JH-2108/RP2040-devboard/BOM.csv

Item | Qty | Supplier | Cost/item | Total Cost | link
Raspberry Pi RP2040CT | 1 | Cytron | $1.15 | $1.15 | https://my.cytron.io/p-raspberry-pi-rp2040-mcu-ic-single-unit
Winbond W25Q128JVSIQ | 1 | LCSC | $2.52 | $2.52 | https://www.lcsc.com/product-detail/C113767.html
12 MHz SMD crystal, 3225 4-pin | 5 | LCSC | $0.10 | $0.50 | https://www.lcsc.com/product-detail/C518158.html
USB Type-C 16-pin receptacle | 1 | Shopee Malaysia | $0.65 | $0.65 | https://shopee.com.my/Type-C-3.1-Patch-Socket-6P-16P-24P-Countersunk-Board-1.6-0.8mm-USB-Female-Socket-Data-Interface-i.513412485.42610897264
3.3 V LDO regulator | 1 | Shopee Malaysia | $0.46 | $0.46 | https://shopee.com.my/AMS1117-Voltage-Regulator-IC-SOT-223-1.2V-1.5V-1.8V-2.5V-3.3V-5V-i.1412281456.49416215365
10 µF ceramic capacitor | 1 | Shopee Malaysia | $0.60 | $0.60 | https://shopee.com.my/100PCS-0603-SMD-Chip-Multilayer-Ceramic-Capacitor-330PF-22uF-1nF-10nF-15nF-100nF-0.1uF-1uF-2.2uF-4.7uF-10uF-i.1135937572.21395687476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
100 nF ceramic capacitor | 10 | Shopee Malaysia | $0.12 | $1.20 | https://shopee.com.my/0402-0603-0805-1206-100nF-820nF-SMD-Chip-Capacitor-i.1467039591.41834021222
5.1 kΩ resistor | 1 | Shopee Malaysia | $1.24 | $1.24 | https://shopee.com.my/SMD-0402-0603-0805-1206-RESISTOR-1K-9.1K-Ohm-i.1467039591.50009312017
1 kΩ resistor | 1 | Shopee Malaysia | $1.24 | $1.24 | https://shopee.com.my/SMD-0402-0603-0805-1206-RESISTOR-1K-9.1K-Ohm-i.1467039591.50009312017
0603 LED | 1 | Shopee Malaysia | $0.88 | $0.88 | https://shopee.com.my/SMD-0402-0603-0805-1206-RESISTOR-1K-9.1K-Ohm-i.1467039591.50009312017
Tactile push button | 1 | Shopee Malaysia | $0.31 | $0.31 | https://shopee.com.my/Button-Switch-Tactile-Push-6x6x5mm-6*6*5mm-4PIN-i.482535902.11217352127
Tactile push button | 1 | Shopee Malaysia | $0.31 | $0.31 | https://shopee.com.my/Button-Switch-Tactile-Push-6x6x5mm-6*6*5mm-4PIN-i.482535902.11217352127
2.54 mm male pin headers | 1 | Shopee Malaysia | $0.30 | $0.30 | https://shopee.com.my/Male-Header-Pins-Straight-Single-Row-40-Pin-0.1-Inch-(2.54mm)-Male-Pin-Header-Connector-PCB-Board-Pin-Connect-i.161803224.7025057004
Custom PCB | 1 | JLCPCB | $5.78 | $5.78 | https://jlcpcb.com
1uF ceramic capcitor | 2 | Shopee Malaysia | $0.45 | $0.90 | https://shopee.com.my/100PCS-0603-SMD-Chip-Multilayer-Ceramic-Capacitor-330PF-22uF-1nF-10nF-15nF-100nF-0.1uF-1uF-2.2uF-4.7uF-10uF-i.1135937572.21395687476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
27Ω resistor | 1 | Shopee Malaysia | $0.93 | $0.93 | https://shopee.com.my/Resistor-SMD-0603-2ohm-20ohm-200ohm-2.2ohm-2.4ohm-24ohm-2.4Kohm-240kohm-2.7ohm-27ohm-270ohm-2.7kohm-5-30-pcs-i.90748406.16145253823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
15pF capacitors | 1 | Shopee Malaysia | $0.80 | $0.80 | https://shopee.com.my/100-Pieces-Original-0603-Patch-Ceramic-Capacitor-50V-4.7-PF-10PF-15PF-20PF-22PF-33-10-1608-i.1922281327.48669360089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
Estimated total shipping | 1 |  |  | $7.75
