JH-2108/RP2040-devboard/PCB/devboard.kicad_pcb

## KiCad design PCB/devboard.kicad_pcb (2026-10-28)

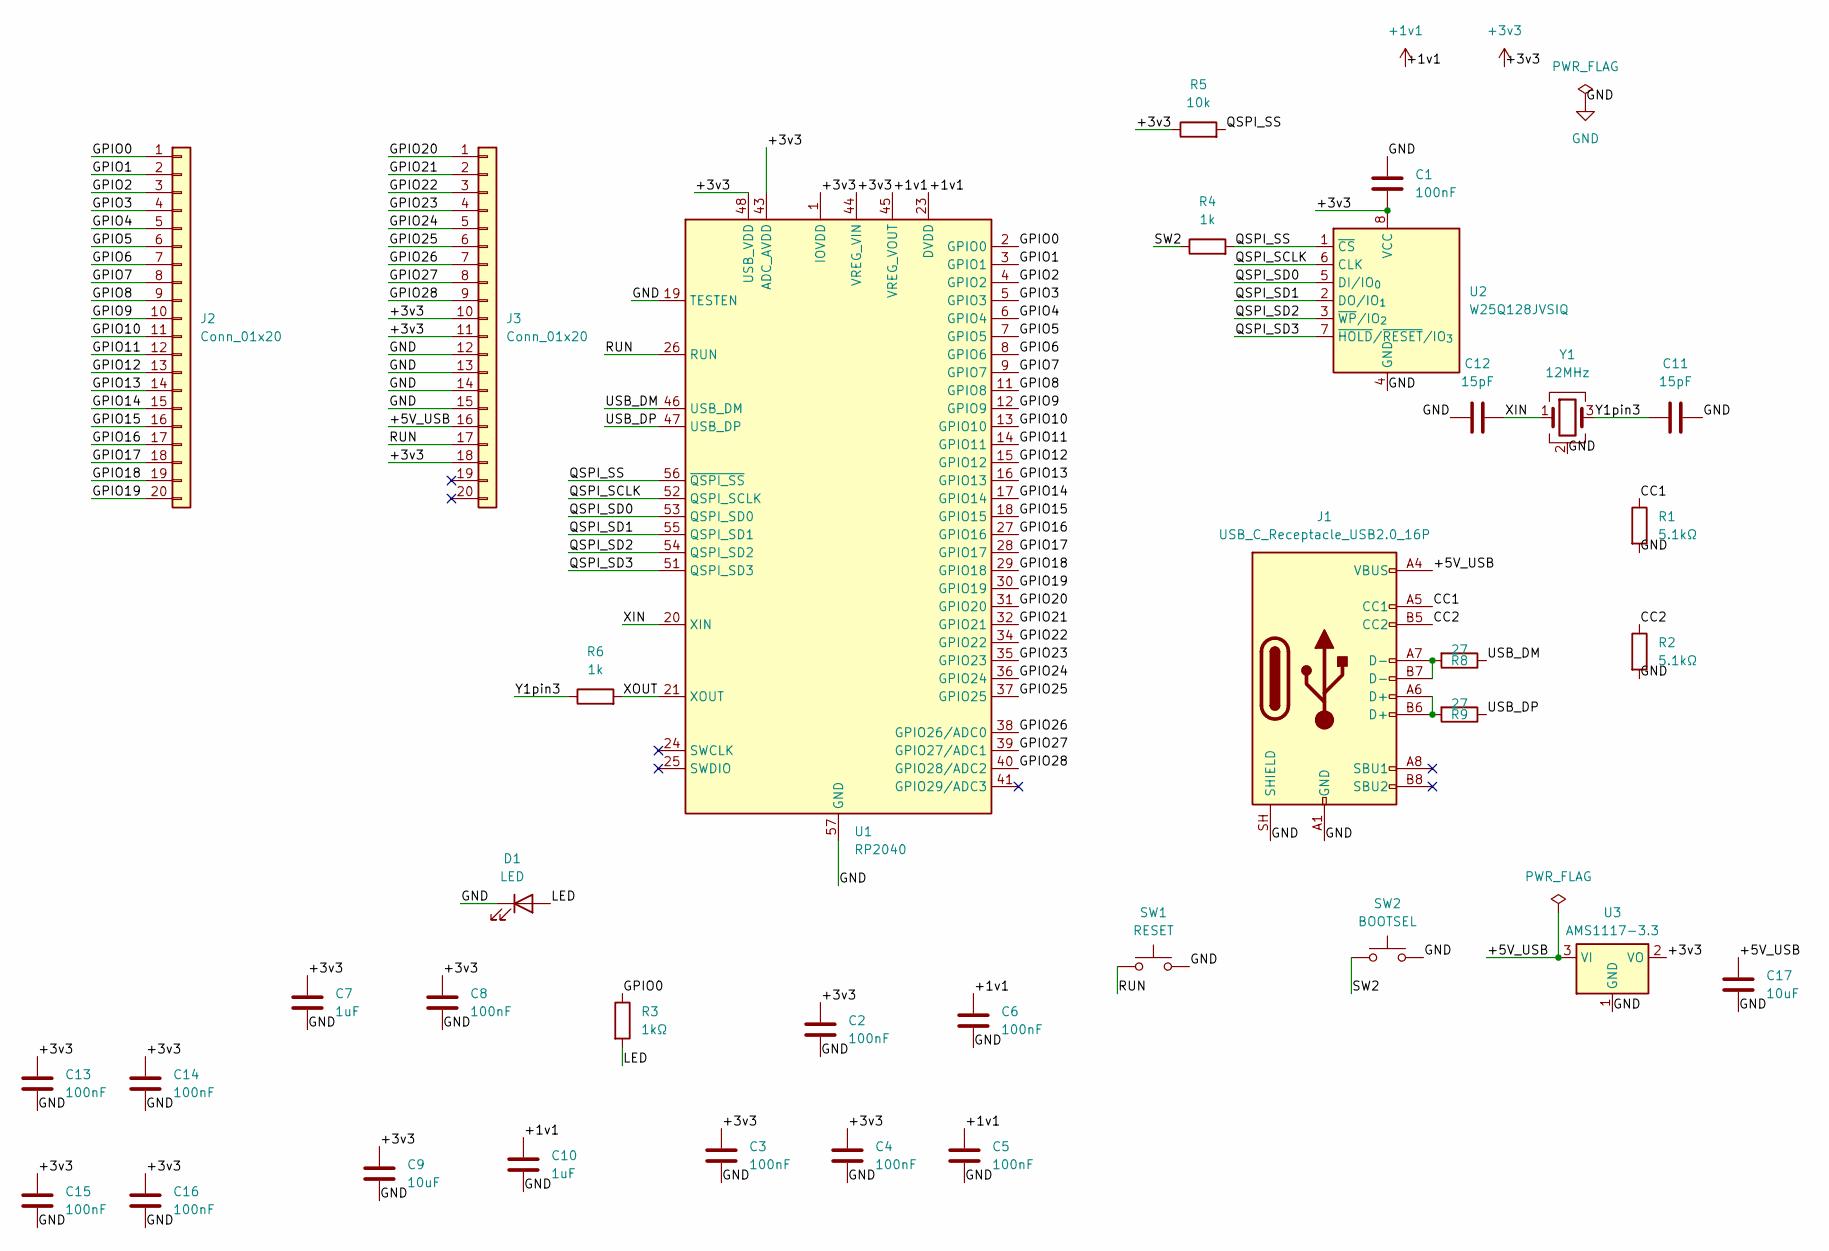
[picture p1: schematic devboard.kicad_sch]

Parts:
C1, C2, C3, C4, C5, C6, C8, C13, C14, C15, C16: 100nF; C_0603_1608Metric
C7, C10: 1uF; C_0603_1608Metric
C9, C17: 10uF; C_0603_1608Metric
C11, C12: 15pF; C_0603_1608Metric
D1: LED; LED_0603_1608Metric
J1: USB_C_Receptacle_USB2.0_16P; USB_C_Receptacle_GCT_USB4105-xx-A_16P_TopMnt_Horizontal
J2, J3: Conn_01x20; PinHeader_1x20_P2.54mm_Vertical
R1, R2: 5.1kΩ; R_0603_1608Metric
R3: 1kΩ; R_0603_1608Metric
R4, R6: 1k; R_0603_1608Metric
R5: 10k; R_0603_1608Metric
R8, R9: 27; R_0603_1608Metric
SW1: RESET; SW_Push_1P1T_NO_E-Switch_TL3301NxxxxxG
SW2: BOOTSEL; SW_Push_1P1T_NO_E-Switch_TL3301NxxxxxG
U1: RP2040; QFN-56-1EP_7x7mm_P0.4mm_EP3.2x3.2mm
U2: W25Q128JVSIQ; SOIC-8_5.3x5.3mm_P1.27mm
U3: AMS1117-3.3; SOT-223-3_TabPin2
Y1: 12MHz; Crystal_SMD_3225-4Pin_3.2x2.5mm

Connections:
+1v1: C5.1, C6.1, C10.1, U1.23 (DVDD), U1.45 (VREG_VOUT), U1.50 (DVDD)
+3v3: C1.2, C2.1, C3.1, C4.1, C7.1, C8.1, C9.1, C13.1, C14.1, C15.1, C16.1, J3.10, J3.11, J3.18, R5.1, U1.1 (IOVDD), U1.10 (IOVDD), U1.22 (IOVDD), U1.33 (IOVDD), U1.42 (IOVDD), U1.43 (ADC_AVDD), U1.44 (VREG_VIN), U1.48 (USB_VDD), U1.49 (IOVDD), U2.8 (VCC), U3.2 (VO)
/+5V_USB: C17.1, J1.A4 (VBUS), J1.A9 (VBUS), J1.B4 (VBUS), J1.B9 (VBUS), J3.16, U3.3 (VI)
/CC1: J1.A5 (CC1), R1.1
/CC2: J1.B5 (CC2), R2.1
/GPIO0: J2.1, R3.1, U1.2 (GPIO0)
/GPIO1: J2.2, U1.3 (GPIO1)
/GPIO2: J2.3, U1.4 (GPIO2)
/GPIO3: J2.4, U1.5 (GPIO3)
/GPIO4: J2.5, U1.6 (GPIO4)
/GPIO5: J2.6, U1.7 (GPIO5)
/GPIO6: J2.7, U1.8 (GPIO6)
/GPIO7: J2.8, U1.9 (GPIO7)
/GPIO8: J2.9, U1.11 (GPIO8)
/GPIO9: J2.10, U1.12 (GPIO9)
/GPIO10: J2.11, U1.13 (GPIO10)
/GPIO11: J2.12, U1.14 (GPIO11)
/GPIO12: J2.13, U1.15 (GPIO12)
/GPIO13: J2.14, U1.16 (GPIO13)
/GPIO14: J2.15, U1.17 (GPIO14)
/GPIO15: J2.16, U1.18 (GPIO15)
/GPIO16: J2.17, U1.27 (GPIO16)
/GPIO17: J2.18, U1.28 (GPIO17)
/GPIO18: J2.19, U1.29 (GPIO18)
/GPIO19: J2.20, U1.30 (GPIO19)
/GPIO20: J3.1, U1.31 (GPIO20)
/GPIO21: J3.2, U1.32 (GPIO21)
/GPIO22: J3.3, U1.34 (GPIO22)
/GPIO23: J3.4, U1.35 (GPIO23)
/GPIO24: J3.5, U1.36 (GPIO24)
/GPIO25: J3.6, U1.37 (GPIO25)
/GPIO26: J3.7, U1.38 (GPIO26/ADC0)
/GPIO27: J3.8, U1.39 (GPIO27/ADC1)
/GPIO28: J3.9, U1.40 (GPIO28/ADC2)
/LED: D1.2 (A), R3.2
/QSPI_SCLK: U1.52 (QSPI_SCLK), U2.6 (CLK)
/QSPI_SD0: U1.53 (QSPI_SD0), U2.5 (DI/IO_{0})
/QSPI_SD1: U1.55 (QSPI_SD1), U2.2 (DO/IO_{1})
/QSPI_SD2: U1.54 (QSPI_SD2), U2.3 (~WP/IO_{2})
/QSPI_SD3: U1.51 (QSPI_SD3), U2.7 (~HOLD/~RESET/IO_{3})
/QSPI_SS: R4.2, R5.2, U1.56 (~QSPI_SS), U2.1 (~CS)
/RUN: J3.17, SW1.1, U1.26 (RUN)
/SW2: R4.1, SW2.1
/USB_DM: R8.1, U1.46 (USB_DM)
/USB_DP: R9.1, U1.47 (USB_DP)
/XIN: C12.2, U1.20 (XIN), Y1.1
/XOUT: R6.2, U1.21 (XOUT)
/Y1pin3: C11.1, R6.1, Y1.3
GND: C1.1, C2.2, C3.2, C4.2, C5.2, C6.2, C7.2, C8.2, C9.2, C10.2, C11.2, C12.1, C13.2, C14.2, C15.2, C16.2, C17.2, D1.1 (K), J1.A1 (GND), J1.A12 (GND), J1.B1 (GND), J1.B12 (GND), J1.SH (SHIELD), J3.12, J3.13, J3.14, J3.15, R1.2, R2.2, SW1.2, SW2.2, U1.19 (TESTEN), U1.57 (GND), U2.4 (GND), U3.1 (GND), Y1.2 (G), Y1.4 (G)
unnamed: J1.A6 (D+), J1.B6 (D+), R9.2
unnamed: J1.A7 (D-), J1.B7 (D-), R8.2

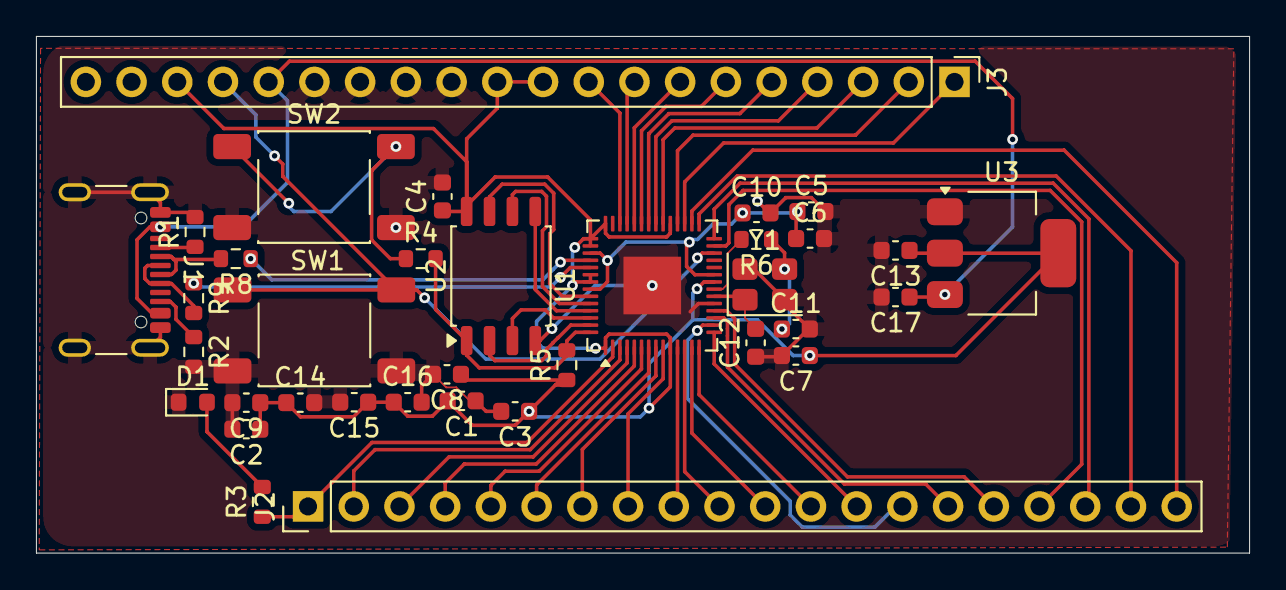
[picture p2: board devboard.kicad_pcb from above]

Board: 2 copper layers, 67.4 x 28.7 mm, 35 parts (0 on the bottom side), 51 nets.
