JH-2108/RP2040-devboard/JOURNAL.md

# Simple devboard: devlog

<!-- Generated by Half Life from project cmuvnsb3i011801o9xqn8m9wa. Edits here are overwritten on the next sync. -->
<!-- Generated: 2026-10-28T17:34:56.982Z -->

> [!NOTE]
> This devlog is mirrored from [Half Life](https://halflife.hackclub.com) ([open the project](https://halflife.hackclub.com/projects/cmuvnsb3i011801o9xqn8m9wa)). Editing it here will not change the platform's copy, and the next sync overwrites this file.

> A custom-designed, compact development board built around the Raspberry Pi RP2040 microcontroller. The board includes native USB-C connectivity, external QSPI flash, 3.3V power regulation, BOOTSEL and reset controls, status indication, and 40GPO breakout pins. It is designed as a general purpose platform for experimenting with embedded programming, sensors, displays, robotics and future hardware projects.

| Week | Tier | Hours logged | Entries |
| --- | --- | --- | --- |
| Week 1 | Tier 1 | 17.1h | 5 |

## Contents

1. [2026-10-06: **Finding an idea, learning KiCAD**](#2026-10-06-finding-an-idea-learning-kicad)
2. [2026-10-06: **PCB DESIGNING**](#2026-10-06-pcb-designing)
3. [2026-10-07: ](#2026-10-07-screenshot-2026-10-07-205429httpshalflifehackclub)
4. [2026-10-19: After completing the entire development board, there were changes regarding the sharp angles of the track connections, the crystal being too far way from the RP2040 microcontroller chip and other issu](#2026-10-19-after-completing-the-entire-development-board-the)
5. [2026-10-28: **More changes**](#2026-10-28-more-changes)

## Design

### 2026-10-06: **Finding an idea, learning KiCAD**

**2h**

**Finding an idea, learning KiCAD**

Well, I had no idea what I wanted to do when I first started, maybe a flight controller (found out it was too expensive), a macropad (was a great idea, but I've done it before and I wanna do something different), a reaction game (tried that, deleted the project because it was a bit over the budget and way to easy), and then I landed on what I have now... A DEVBOARD!!!

Besides just making my idea reel, I also fully designed the entire PCB layout and schematics in KiCAD, successfully completing the creation of the entire DevBoard, which could be manufactured right now. However, you don't know me, I like to test if it works, and during my PCB layout creation, I faced so many difficulties, like the clearance issues on a FOOTPRINT, LITERALLY DESIGNED BY KICAD... Hence, I found a way to overcome it by changing the clearance value.

In the end, it took me 2 hours to work on the PCB layout, what type of parts to use, learning how to use KiCAD, while also checking if the parts that I need for this project are all on the KiCAD symbol and footprint library. It was a ton of work, but, hey, I finally did it, I got a great difficult project idea for a cost below 30usd, a PCB design that I can really work on, which will be quite fun to do so too, and how to solder those super tiny resistors and capacitors when the parts finally arrive at my doorstep!

To summarize what I did, I basically learnt how to use KiCAD, how to solder, and sketch up some ideas, and spent some of these time filming my reel!

Anyways, enough of my yapping, here are some images of my project:





### 2026-10-06: **PCB DESIGNING**

**3.6h**

**PCB DESIGNING**

Some pictures of my PCB designing, includes the schematics, PCB, and 3d rendered version. An additional 1 hour and 30-ish minutes was used to handle certain PCB designing issues, and learning how KiCAD works! (including solving some problems that I had with KiCAD that isn't recorded in the timelapse.







[Timelapse](https://lookout.hackclub.com/api/media/49bfa0d1-a2d1-49ec-b1c6-9895ec110794/video.mp4)

[Timelapse](https://lookout.hackclub.com/api/media/312bf0b2-ec24-4d46-80e0-ec4d2dc14f10/video.mp4)

### 2026-10-07: 

**5.5h**



**PREPARING FIRMWARE ENVIRONMENT**

Well, a development board doesn't always need a firmware for it to run, since, yk, the chips provide the main codes for all the other components to run along with how you are the one coding in order to make the devboard work.

However, as for me, I decided that, yk, I have a lot of free time, and also I haven't complete my 10 hour progress for this project, hence, I decided, why not I code the firmware to test the board first, then later on, when it is time to test the board, I'll just load the firmware onto the board and make sure it works. Hence, I took 4 hours of my time, downloading software, recoding certain firmwares and using a Raspberry Pi Pico extension from VSC to create an example project (blink), in hopes that when the parts for the devboard come, I am able to assemble it and build it.

You may be wondering, how did I spend 5 hours on downloading the softwares and all for the testing, well, there were a ton of compatibility issues, deleting my files over and over again, watched some tutorials on how to fix certain issues, and,  well, maybe use some ChatGPT to more efficiently solve them for me. But at least, at the end, I was able to solve all the issues that I was facing, successfully creating the testing environment for the devboard!

Below are the pictures of what I did, such as the download pages, the coding parts, and waiting a long time for some software to finish downloading!











### 2026-10-19: After completing the entire development board, there were changes regarding the sharp angles of the track connections, the crystal being too far way from the RP2040 microcontroller chip and other issu

**3h**

After completing the entire development board, there were changes regarding the sharp angles of the track connections, the crystal being too far way from the RP2040 microcontroller chip and other issues. In order to address and resolve these issues, I needed to use the global deletions tool in KiCAD, and then reconnect it, until I find another problem that the wire can't connect, then I deleted everything again and redo it again, this happened so many times, inflating the amount of time that I spend on the development board just from the few adjustments that the reviewer told me to make, in the end, I was able to make these adjustments and re-track certain parts of the board instead of doing everything again. The one thing I learnt from these fixes is that I could've shorten the width of the wires, never thought of doing that until I faced an issue with the crystal, but oh well... You learn something new with mistakes I guess.



the crystal distance between the RP2040 microcontroller chip



making the track wire thinner, went from a 0.2mm track width to a 0.1mm track width, the distances are also shorter with all of the wires within the crystal connections being shorter than 10mm.



the new development board version

### 2026-10-28: **More changes**

**3h**

**More changes**

According to the reviewers on my project, they mentioned issues about my decoupling capacitors and referred me to the guide in order to fix it. Hence, I went back to KiCAD, making changes to the schematics to make it look nicer and more organized, which I then found other issues on the capacitors and resistors, such as them repeating multiple times, and the calculations for the capacitors on the crystal, which is very important for the information transfer throughout the entire devboard.

This is my schematics now



This is the PCB design now, I've also added the GND filling hence, reducing the amount of tracks that I need to put for the GND net.



And lastly I've also increased the distance between the LDO VIN regulator chip to the crystal, hence, the heat released by the chip into the board won't damage the crystal or the RP2040 chip in the middle.
